Projetos-Integradores-Univesp/senior-sos-device/hardware/Apoio versões anteriores/Hardware HM-364A/pinout hw-364A.png

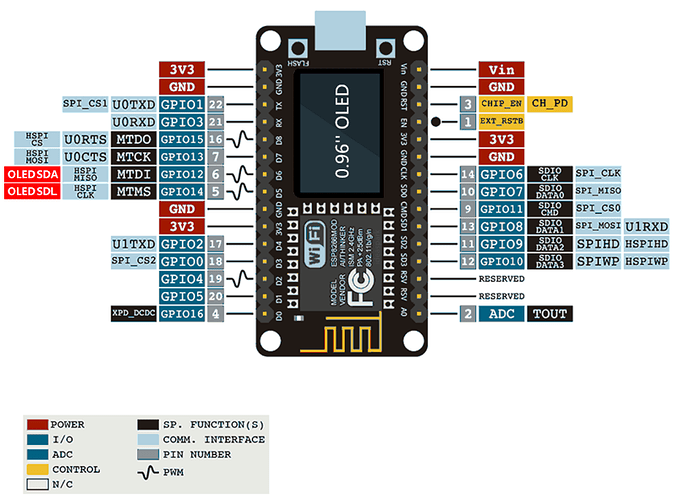
hardware/Apoio versões anteriores/Hardware HM-364A/pinout hw-364A.png
