Projetos-Integradores-Univesp/senior-sos-device/README.md

# Senior SOS Device

Desenvolvimento de dispositivo IoT para disparo de alerta de emergência via rádio frequência para atendimento emergencial de idosos.

Desenvolvimento de aplicativo móvel para recebimento dos alertas e gerenciamento do dispositivo com integração ao backend.

Projeto realizado no Projeto Integrador III -1º Semestre de 2026 da Universidade Virtual do Estado de São Paulo (UNIVESP) - Eixo Computação.

Colaboradores              | RA
---------------------------|---
Fernando da Silva Pinto    | 23222055
João Toldo                 | 23204753
Jônatas Marques de Farias  | 2204866
Jorge Roberto Isabella     | 23227995
Osmar Mendes dos Santos    | 23216216
Rubens Eduardo de Carvalho | 23202674
Tiago Diniz Barbieri       | 23206102
