Projetos-Integradores-Univesp/senior-sos-device/backend/README.md

# Instruções Gerais

## Comandos para iniciar o servidor *uvicorn*

Para iniciar o servidor backend, executar na raiz do projeto, o comando: `uvicorn backend.main:app --reload`.
Após o servidor estar funcionando, acessar pelo navegador: <http://127.0.0.1:8000/docs> (Swagger).

## Para fazer migrações, seguir os passos

### Configurações iniciais

1. No terminal rodar: `cd backend/migrations/`
2. No terminal rodar: `alembic init alembic`
3. Editar o link do DB dentro do arquivo ***alembic.ini***
    - linha 90: `sqlalchemy.url = sqlite:///../database.db`
4. Dentro da pasta ***"migrations/alembic"*** Editar o arquivo ***env.py***
    - Acrescentar as linhas:
        ```python
        import os, sys
        BASE_DIR = os.path.dirname(os.path.dirname(os.path.dirname(os.path.dirname(os.path.abspath(__file__)))))
        sys.path.append(BASE_DIR)
        from backend.models import Base
        ```
    - Modificar a linha 27: `target_metadata = Base.metadata`

### Criar, executar e editar uma migração

1. No terminal rodar: `cd backend/migrations/`
2. No terminal rodar o comando: `alembic revision --autogenerate -m "titulo_da_migração"`
3. Editar o arquivo python de migração dentro da pasta ***"migrations/alembic/versions"***
    1. Alterar o campo ***"type"*** dentro da tabela ***"events"***:
        - de: `sqlalchemy_utils.types.choice.ChoiceType(length=255)`
        - para: `sa.String(length=32)`
4. Executar a migração com: `alembic upgrade head`

## Rotas

### users
- [x] ***POST   /users***         --> para criar conta de novo usuário
- [x] ***PUT    /users/me***      --> para editar conta de usuário (necessário autenticação)
- [x] ***DELETE /users/me***      --> para excluir conta (necessário autenticação)

### auth
- [x] ***POST   /auth/login***         --> para fazer login (cria seção/token)
- [x] ***POST   /auth/login-swagger*** --> para fazer login utilizando o Swagger apenas para teste (cria seção/token)
- [x] ***POST   /auth/logout***        --> para fazer logout (invalida seção/token)
- [x] ***GET    /auth/refresh***       --> para fazer refresh da seção (com o refresh_token)

### devices
- [x] ***GET    /devices***       --> para listar dispositivos (necessário autenticação)
- [x] ***POST   /devices***       --> para adicionar dispositivos (necessário autenticação)
- [x] ***PUT    /devices/{id}***  --> para editar dispositivos (necessário autenticação + admin)
- [x] ***DELETE /devices/{id}***  --> para apagar dispositivo (necessário autenticação + admin)
- [x] ***GET    /devices/{id}/users***  --> para listar usuários com acesso ao dispositivo (necessário autenticação + admin)
- [x] ***POST   /devices/{id}/users/{username}*** --> para adicionar novo acesso de usuário ao disp (necessário autenticação + admin)
- [x] ***DELETE /devices/{id}/users/{username}***  --> para remover o acesso de um usuário ao dispositivo (autenticação + admin)
- [x] ***GET    /devices/{id}/events*** --> para listar todos os eventos relacionados ao dispositivo (autenticação)
