Projetos-Integradores-Univesp/senior-sos-device/hardware/Apoio versões anteriores/Hardware Waveshare ESP32-S3-A7670E/elderly_wearable/docs/ElderGuard_Relatorio_Tecnico.docx

ElderGuard

Dispositivo Vestível IoT para Segurança de Idosos

Relatório Técnico Abrangente

Março 2026

Plataforma: ESP32-S3-A7670E-4G (Waveshare) + BNO086 IMU

# 1. Introdução

O ElderGuard é um dispositivo vestível IoT projetado para a segurança de pessoas idosas. Ele combina detecção de quedas por acelerômetro/giroscópio, botão de pânico, rastreamento GPS e conectividade 4G/WiFi/Bluetooth para enviar alertas em tempo real a cuidadores e familiares.

O sistema opera em ciclos de deep sleep para maximizar a autonomia da bateria, despertando apenas por temporizador periódico, pressionamento do botão de pânico ou detecção de movimento súbito pela IMU.

## 1.1 Objetivos do Projeto

Detecção automática de quedas com confirmação em três fases (queda livre, impacto, inatividade).

Botão de pânico com envio imediato de SMS e publicação MQTT com coordenadas GPS.

Rastreamento periódico de localização GPS com publicação em dashboard web em tempo real.

Consumo mínimo de energia via deep sleep com múltiplas fontes de despertar.

Registro local em cartão SD com timestamps UTC e espelhamento remoto via ESP-NOW.

# 2. Hardware e Esquemático

## 2.1 Placa Principal: ESP32-S3-A7670E-4G

Placa de desenvolvimento Waveshare com processador ESP32-S3R2 dual-core Xtensa LX7 a 240 MHz, 512KB SRAM, 2MB PSRAM, 16MB Flash. Integra módulo celular A7670E-FASE com suporte a LTE Cat-1, 2G, GNSS, chamadas telefônicas e SMS.

### 2.1.1 DIP Switches

A placa possui 4 chaves DIP na parte traseira que controlam alimentação e roteamento de periféricos:

Chave | Função
CAM | Liga/desliga alimentação da câmera. DEVE estar OFF para usar MAX17048 em placas V2 (conflito GPIO 15/16).
HUB | Controla alimentação do circuito USB HUB.
4G | Liga/desliga alimentação do módulo A7670E.
USB | Chaveia canal USB entre ESP32-S3 e A7670E.

## 2.2 IMU: BNO086

Unidade de medição inercial Hillcrest/CEVA BNO086 com processador de fusão sensorial integrado. Comunicação I2C a 400 kHz no endereço 0x4B (confirmado via diagnóstico). O pino INT (interrupção) é conectado ao GPIO 3 (RTC-capable) para despertar o ESP32 do deep sleep via ext0.

### 2.2.1 Mapa de Conexões BNO086

Pino BNO086 | GPIO ESP32 | Observação
VCC | 3V3 | Alimentação 3.3V
GND | GND | Terra comum
SDA | GPIO 2 | I2C dados (pull-up 4.7kΩ para 3.3V)
SCL | GPIO 1 | I2C clock (pull-up 4.7kΩ para 3.3V)
INT | GPIO 3 (RTC) | Interrupção — fonte de despertar ext0
RST | GPIO 47 | Reset hardware (não usar GPIO 4 — conflito SD)
PS0 | GND | Modo I2C (PS0=GND, PS1=GND)
PS1 | GND | Modo I2C

## 2.3 Medidor de Bateria: MAX17048

Fuel gauge Maxim MAX17048 integrado na placa, comunicação I2C no endereço 0x36. Utiliza barramento I2C separado do BNO086 (Wire1). Implementa o algoritmo ModelGauge para estimativa precisa do estado de carga (SoC) sem necessidade de resistor shunt.

### 2.3.1 Pinagem por Versão da Placa

Versão | SDA | SCL | Inicialização
V1 | GPIO 3 | GPIO 2 | Wire1.begin(3, 2)
V2 | GPIO 15 | GPIO 16 | Wire1.begin(15, 16) — CAM OFF!

## 2.4 Botão de Pânico

Botão normalmente aberto conectado entre GPIO 0 e GND. Pull-up interno habilitado. Pressionamento puxa o pino para LOW, acionando despertar ext1 do deep sleep. Debounce de 50ms implementado em software.

## 2.5 Cartão SD

Slot para cartão microSD integrado na placa. Utiliza interface SDMMC em modo 1-bit com CLK=GPIO5, CMD=GPIO4, DATA=GPIO6. Montagem sob demanda (lazy mount) para evitar conflitos com barramento I2C durante operações da IMU.

## 2.6 Bateria

Bateria 18650 Li-ion 3000 mAh / 3.7V nominal no suporte integrado da placa. Carregamento via USB (ETA6098) e painel solar (CN3791). Proteção contra inversão de polaridade com LED amarelo indicador.

# 3. Bibliotecas Utilizadas

Biblioteca | Versão | Função
TinyGSM (fork LilyGo) | Customizada | Interface AT para A7670E: rede, GPRS, GPS, SMS. Fork específico com suporte A7670/A7608.
PubSubClient | 2.8+ | Cliente MQTT sobre WiFiClient ou TinyGsmClient.
SparkFun BNO08x | 1.1.0+ | Driver para IMU BNO086 via I2C (protocolo SH-2).
ESP32 BLE Arduino | Core ESP32 | Servidor BLE GATT para comunicação com app companion.
SD_MMC | Core ESP32 | Acesso ao cartão SD via interface SDMMC 1-bit.
esp_now.h | Core ESP32 | Espelhamento serial via ESP-NOW para NodeMCU ESP8266.
Wire.h | Core Arduino | Comunicação I2C — Wire (BNO086) e Wire1 (MAX17048).
esp_sleep.h | ESP-IDF | Configuração de deep sleep e fontes de despertar.

IMPORTANTE: A biblioteca TinyGSM deve ser a versão fork da LilyGo disponível em github.com/Xinyuan-LilyGO/LilyGo-Modem-Series. A versão padrão do Library Manager NÃO suporta o A7670E corretamente.

# 4. Configuração do Sistema

## 4.1 Arquivo config.h

Centraliza todas as definições de pinos, endereços I2C, credenciais de rede, limiares de detecção e tópicos MQTT. Principais parâmetros configuráveis:

### 4.1.1 Conectividade

CELLULAR_APN: APN da operadora do chip SIM (ex: "claro.com.br" para Claro Brasil).

WIFI_SSID / WIFI_PASSWORD: Credenciais WiFi (opcional, pular se definido como "YourSSID").

MQTT_BROKER: Endereço do broker Mosquitto (iot.gtpc.com.br).

MQTT_USER / MQTT_PASSWORD: Credenciais de autenticação MQTT.

ALERT_PHONE_NUMBER: Número do cuidador para SMS de emergência.

### 4.1.2 Detecção de Queda

FALL_ACCEL_THRESHOLD (30.0 m/s²): Limiar de aceleração para impacto.

FALL_GYRO_THRESHOLD (250.0 °/s): Limiar de rotação para tombamento.

FALL_FREEFALL_THRESHOLD (2.0 m/s²): Limiar de queda livre (aceleração próxima de zero).

FALL_FREEFALL_DURATION_MS (80 ms): Duração mínima da fase de queda livre.

FALL_CONFIRM_WINDOW_SEC (5 s): Janela de confirmação por inatividade pós-impacto.

### 4.1.3 Temporização

SLEEP_INTERVAL_SEC (300 s = 5 min): Intervalo entre heartbeats periódicos.

MAX17048_ALERT_THRESHOLD (10%): Limiar de alerta de bateria baixa no fuel gauge.

## 4.2 Servidor VPS (iot.gtpc.com.br)

O servidor executa Mosquitto (broker MQTT) e nginx (proxy WebSocket + dashboard).

### 4.2.1 Mosquitto

Listener MQTT na porta 1883 (conexões do dispositivo via 4G/WiFi).

Listener WebSocket na porta 9001 (conexões do dashboard via navegador).

Autenticação por senha (mosquitto_passwd) com ACL por tópico.

Persistência habilitada para mensagens retidas (elderguard.db).

### 4.2.2 nginx

HTTPS com certificado Let's Encrypt. Proxy WebSocket em /mqtt apontando para Mosquitto 9001. Serve arquivos estáticos do dashboard em /var/www/elderguard/.

### 4.2.3 Tópicos MQTT

Tópico | QoS | Retido | Conteúdo
elderguard/001/alert | 1 | Sim | Alertas de pânico/queda com GPS
elderguard/001/location | 1 | Sim | Coordenadas GPS, altitude, velocidade
elderguard/001/telemetry | 1 | Sim | Bateria, sinal, boot count, transporte
elderguard/001/status | 1 | Sim | Online/offline via LWT
elderguard/001/debug | 0 | Sim | Log de boot remoto (substitui Serial)
elderguard/001/command | 1 | Não | Comandos: locate, ping, interval:N

# 5. Algoritmos Detalhados

## 5.1 Ciclo Principal: Despertar → Avaliar → Agir → Dormir

O firmware opera em ciclo de deep sleep. A cada despertar, o setup() executa a seguinte sequência:

1. Inicialização ESP-NOW para espelhamento de debug.

2. Determinação da razão de despertar (timer, botão, IMU, power-on).

3. Reset hardware do BNO086 via pino RST para limpar interrupções pendentes.

4. Inicialização do fuel gauge MAX17048 via Wire1 com quick-start e espera de 600ms.

5. Leitura de bateria com verificação cruzada (SoC vs tensão) para evitar falsos alertas.

6. Roteamento para o handler apropriado conforme a razão de despertar.

7. Desconexão MQTT, desmontagem SD, drenagem de interrupções IMU, deep sleep.

## 5.2 Detecção de Queda (Algoritmo Trifásico)

Implementado em imu.h, o algoritmo opera em três fases sequenciais:

### Fase 1: Detecção de Queda Livre

Monitora a magnitude da aceleração linear (sem gravidade, fornecida pelo processador de fusão do BNO086). Quando a magnitude cai abaixo de FALL_FREEFALL_THRESHOLD (2.0 m/s²), indica que o corpo está em queda livre. O timestamp do início é registrado.

### Fase 2: Detecção de Impacto

Após a detecção de queda livre, monitora um pico de aceleração acima de FALL_ACCEL_THRESHOLD (30.0 m/s²) que ocorra dentro de 1 segundo após o início da queda livre e com duração mínima de FALL_FREEFALL_DURATION_MS (80ms). Simultaneamente, verifica rotação rápida (giroscópio > FALL_GYRO_THRESHOLD) como indicador suplementar de tombamento.

### Fase 3: Confirmação por Inatividade

Utiliza o classificador de estabilidade integrado do BNO086 (report 0x13). Se após o impacto a pessoa permanece estacionária por FALL_CONFIRM_WINDOW_SEC (5 segundos), a queda é confirmada. Isso distingue uma queda real de um tropeço onde a pessoa se recupera.

## 5.3 Gerenciamento de Energia

### 5.3.1 Deep Sleep com Múltiplas Fontes de Despertar

O ESP32-S3 suporta três fontes simultâneas de despertar:

Timer (esp_sleep_enable_timer_wakeup): Despertar periódico a cada SLEEP_INTERVAL_SEC para heartbeat.

EXT0 (esp_sleep_enable_ext0_wakeup): Pino INT do BNO086 (GPIO 3) em nível LOW indica movimento significativo. Só habilitado se INT estiver HIGH no momento de dormir.

EXT1 (esp_sleep_enable_ext1_wakeup): Botão de pânico (GPIO 0) em nível LOW.

### 5.3.2 Drenagem de Interrupções Antes do Sleep

Antes de configurar ext0, o firmware verifica se o pino INT está LOW. Se estiver, abre o barramento I2C e lê blocos de 32 bytes do BNO086 até INT retornar a HIGH (timeout 2s). Sem isso, o ESP32 despertaria imediatamente após dormir, criando um loop infinito de despertar.

### 5.3.3 MAX17048 Sleep Mode

Opcionalmente (MAX17048_SLEEP_WITH_ESP=true), o fuel gauge é colocado em sleep mode (~0.5µA vs ~23µA ativo). Na inicialização, quick-start é emitido com espera de 600ms para estabilização do SoC.

### 5.3.4 Verificação Cruzada de Bateria

Para evitar falsos alertas de bateria crítica causados por leitura de SoC=0% antes da estabilização do gauge, isBatteryCritical() verifica: (a) se o gauge está respondendo (retorno -1 = offline, não crítico); (b) se SoC < 10%, cruza com tensão da célula — se V > 3.5V, a leitura de SoC está incorreta e é ignorada.

## 5.4 Comunicação MQTT

Prioridade de transporte:

1. WiFi + PubSubClient: Mais rápido, menor consumo. Só tenta se SSID configurado.

2. 4G + TinyGsmClient + PubSubClient: TinyGsmClient fornece interface Arduino Client sobre TCP via modem. PubSubClient fala MQTT sobre essa conexão. Requer GPRS ativo com IP atribuído.

### 5.4.1 Last Will and Testament (LWT)

Na conexão MQTT, configura LWT no tópico .../status com payload {"online":false} retido. Se o dispositivo dormir sem desconectar limpo, o broker publica automaticamente o status offline.

### 5.4.2 Reconhecimento de Alarmes

O dashboard pode publicar mensagem retida vazia no tópico .../alert para limpar alertas pendentes, e sobrescrever o status com {"online":true}. O ACL do Mosquitto permite escrita do usuário dashboard nesses tópicos.

## 5.5 GPS via A7670E

O módulo GNSS integrado do A7670E requer sequência específica de ativação:

1. Envio de AT+CGNSSPWR=1 via modem.sendAT().

2. Espera pela resposta assíncrona +CGNSSPWR: READY! (até 10 segundos).

3. Consultas periódicas via modem.getGPS() que internamente envia AT+CGNSSINFO.

4. TinyGSM retorna coordenadas em graus decimais com sinal (negativo para S/W).

Timeout padrão de 90 segundos para cold start. Intervalo entre consultas de 3 segundos.

## 5.6 Registro em Cartão SD

Formato CSV com colunas: timestamp, event, batt_pct, batt_v, charge_rate, lat, lon, alt, speed_kmh, sats, signal, boot, transport. Montagem SDMMC sob demanda (após operações I2C da IMU) para evitar conflitos GPIO. Header criado automaticamente na primeira escrita.

## 5.7 Espelhamento Serial via ESP-NOW

Cada chamada a logDebug() além de escrever em Serial e no buffer MQTT, transmite a mensagem via ESP-NOW em broadcast (FF:FF:FF:FF:FF:FF). Um ESP8266 NodeMCU com o sketch espnow_receiver.ino recebe e imprime na sua Serial, funcionando como monitor serial wireless para debugging em modo bateria.

## 5.8 BLE (Bluetooth Low Energy)

Servidor GATT com serviço customizado expondo três características: Location (notify — coordenadas GPS), Status (notify — bateria/sinal), Command (write — comandos do app). Advertising breve (2-10 segundos por ciclo) para conservar energia.

# 6. Estimativa de Consumo de Energia

Estado | Corrente | Duração | Observação
Deep sleep | ~10 µA | ~295 s | ESP32-S3 + BNO086 + MAX17048 sleep
GPS fix (A7670E) | ~120 mA | ~30 s | GNSS ativo, cold start pior caso
4G transmissão | ~250 mA | ~8 s | MQTT publish via TCP
WiFi MQTT | ~160 mA | ~3 s | Mais rápido que 4G
BNO086 sensoriamento | ~1.5 mA | ~8 s | Confirmação de queda
BLE advertising | ~15 mA | ~2 s | Janela breve por ciclo

Estimativa de autonomia com heartbeats a cada 5 minutos via 4G: 3-5 dias (bateria 3000 mAh). Aumentar SLEEP_INTERVAL_SEC para 600 (10 min) estende para ~5+ dias.

# 7. Estrutura do Projeto

Arquivo | Descrição
elderly_wearable.ino | Sketch principal — ciclo despertar/avaliar/agir/dormir, handlers de eventos
config.h | Definições de pinos, limiares, credenciais, tópicos MQTT
cellular.h | Wrapper TinyGSM — modem, GPRS, GPS manual, SMS, hora da rede
mqtt_manager.h | MQTT multi-transporte — WiFi PubSubClient + 4G TinyGsmClient
power.h | Deep sleep, fontes de despertar, MAX17048 fuel gauge via Wire1
imu.h | BNO086 driver + algoritmo de detecção de queda trifásico
ble_manager.h | Servidor BLE GATT para app companion
sdlog.h | Logger CSV em cartão SD via SDMMC
espnow_mirror.h | Broadcast ESP-NOW de linhas de debug
espnow_receiver/ | Sketch receptor para ESP8266 NodeMCU
server/dashboard/ | Dashboard HTML com Leaflet, MQTT.js, telemetria em tempo real
server/mosquitto/ | Configuração Mosquitto + ACL
server/nginx/ | Configuração nginx HTTPS + proxy WebSocket

# 8. Problemas Conhecidos e Soluções Aplicadas

Durante o desenvolvimento, diversos problemas foram identificados e resolvidos:

Pinos RX/TX invertidos: A documentação do ESP32-S3 define Serial1.begin(baud, config, rxPin, txPin) onde o terceiro parâmetro é RX. Os pinos estavam invertidos, causando silêncio total do modem.

Envio AT rápido demais: O A7670E requer envio caractere-a-caractere com delay de 10ms entre bytes. O uso de println() causava descarte silencioso de comandos.

GPS parsing incorreto: O formato +CGNSSINFO do A7670E possui 4 campos de satélite (GPS, GLONASS, BEIDOU + reservado) antes da latitude, não 3. Resolvido usando TinyGSM que faz parsing interno.

MAX17048 barramento errado: O fuel gauge está em barramento I2C separado do BNO086, com pinagem diferente entre versões V1/V2 da placa.

Conflito GPIO SD/IMU: GPIO 4 (SD_CMD) conflitava com BNO086_RST. Resolvido movendo RST para GPIO 47.

WiFi.begin() mata Serial USB-CDC: No ESP32-S3, inicialização do rádio WiFi interfere com a interface USB-CDC. Resolvido pulando WiFi se SSID não configurado.

INT IMU sempre LOW: Interrupções pendentes de sessão anterior mantinham INT ativo. Resolvido com reset hardware + drenagem de eventos antes do sleep.

Mensagens MQTT retidas fantasmas: Alertas falsos de bateria baixa persistiam no broker. Resolvido com botão Acknowledge no dashboard que publica mensagem retida vazia.

Sem conexão de dados 4G: SMS funcionava mas MQTT não. Faltava ativação do contexto PDP (AT+CGACT). Resolvido usando TinyGSM que gerencia GPRS automaticamente.

ElderGuard — Relatório Técnico
