Projetos-Integradores-Univesp/senior-sos-device/(commit log)

2026-03-22 Adicionado software Waveshare
    Software preliminar para a placa ESP32-S3-A7670E com 4G/GPS/IMU/Botâo de pânico funcionando. Necessita mais testes do IMU.
2026-04-09 Adiciona gerenciamento de dispositivos com funcionalidades de adicionar, editar e remover aparelhos
2026-04-09 Remove banner de modo de depuração no aplicativo
2026-04-09 Adiciona gerenciamento de alertas com abas para dispositivos e alertas
2026-04-10 Adicionar arquivo de recomendações de extensões do VSCode
2026-04-12 Start devices router.
2026-04-12 Added get devices router.
2026-04-13 Added edit device router.
2026-04-13 Return device id to client.
2026-04-13 Added delete device router.
2026-04-30 Atualização XIAO ESP32S3
    Atualização para a versão do código XIAO ESP32S3
2026-06-16 Added new publish test for respond devices.
